joaquincasanova/ArdaraClone/docs/hs27.pdf

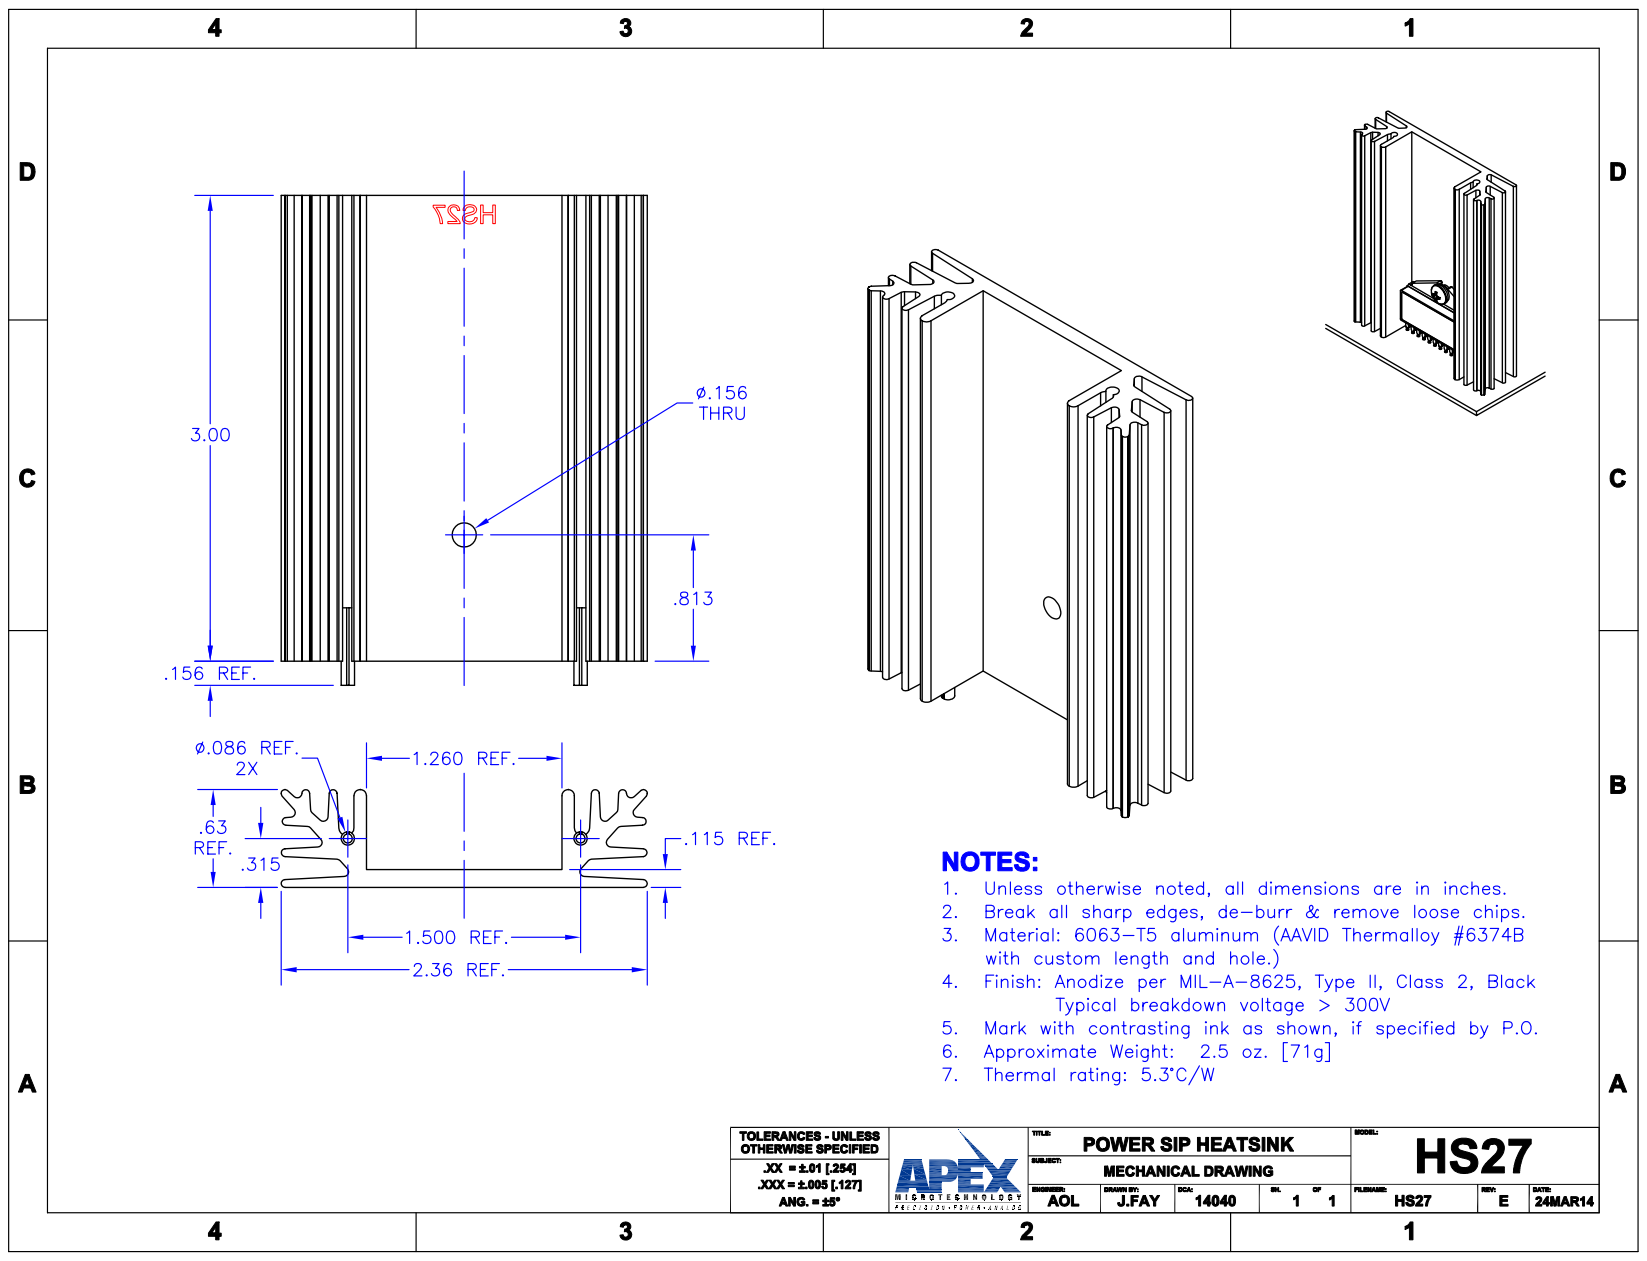
[picture p5: page 1]
