joaquincasanova/ArdaraClone/docs/dr.pdf

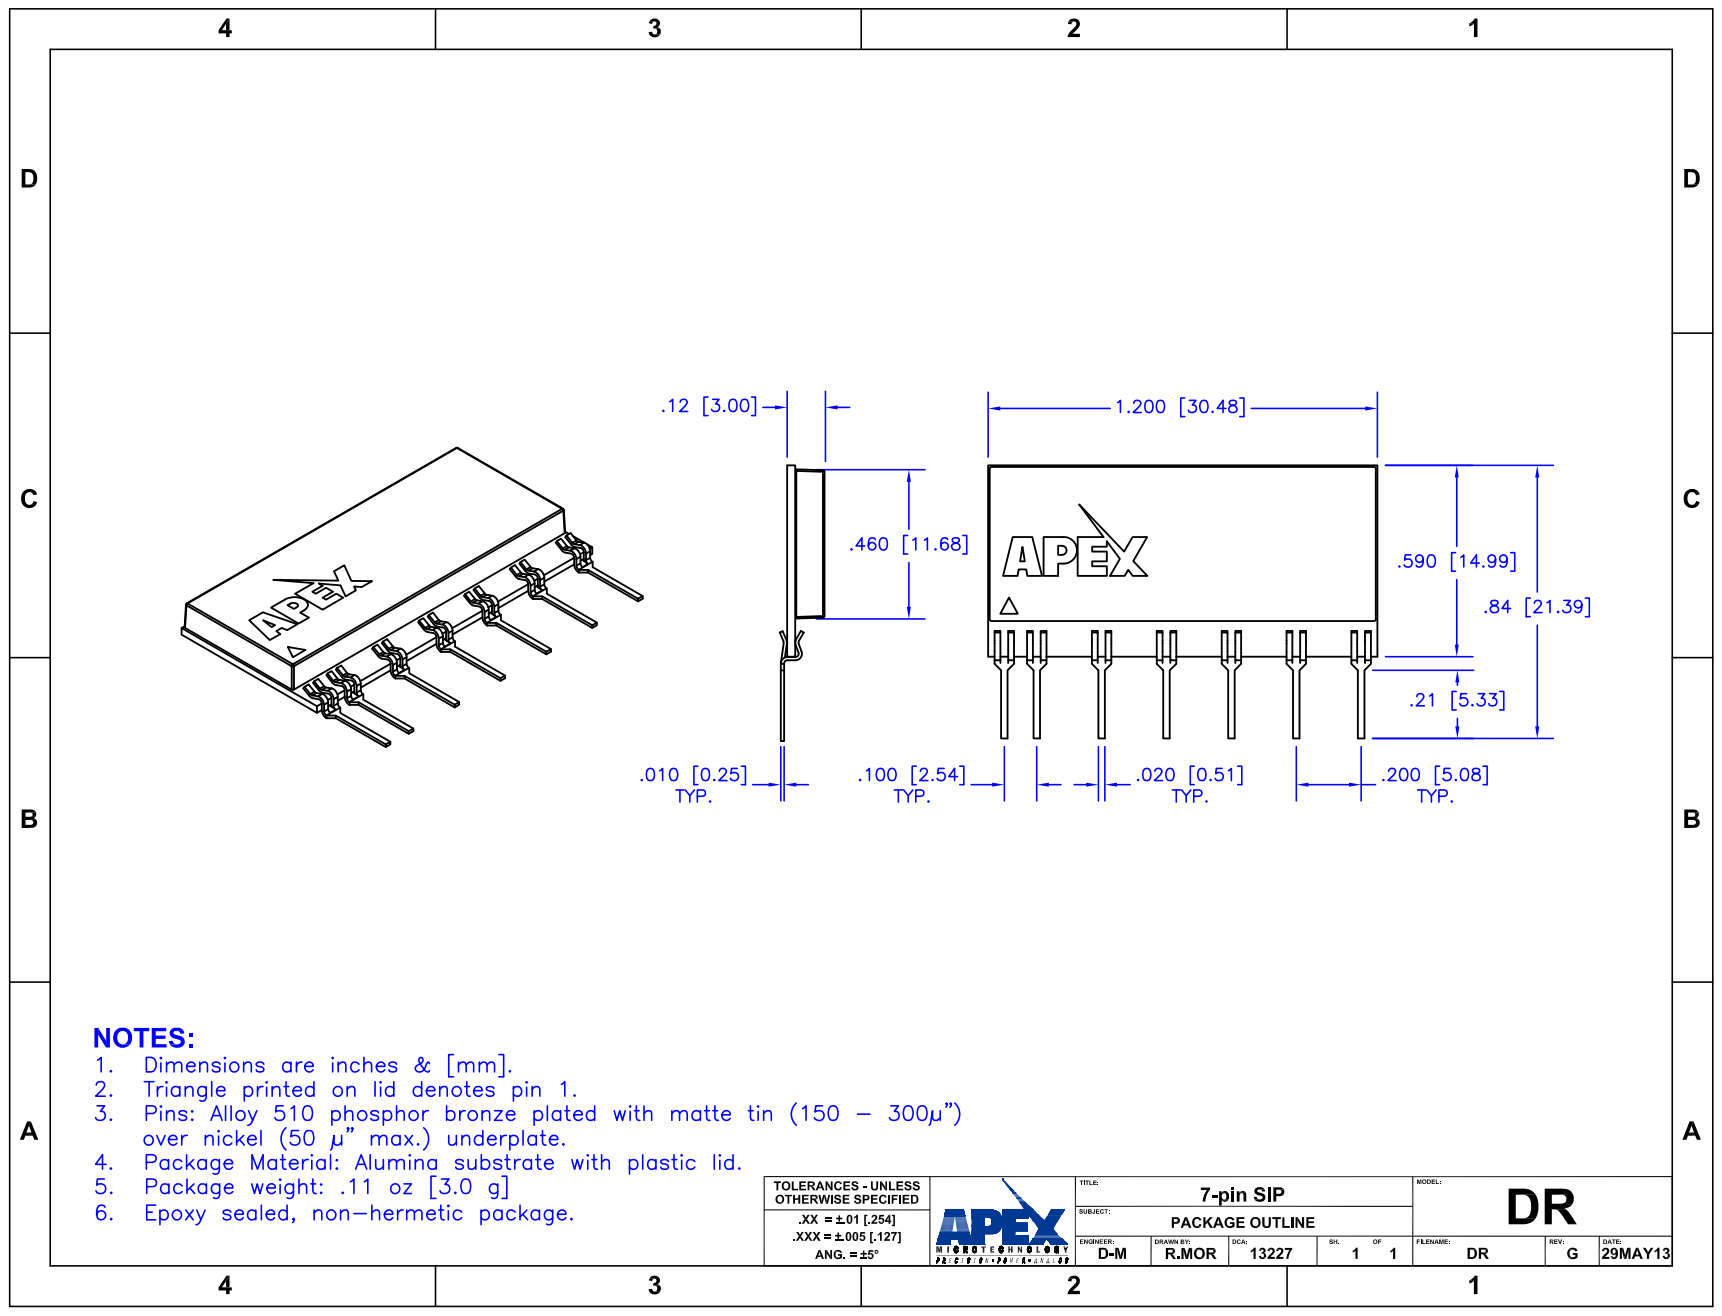
[picture p6: page 1]
