joaquincasanova/ArdaraClone/spice/summer.asc

R1: res; 240k
R2: res; 50k
R3: res; 50k
R12: res; 240k
U2: LT1355
V3: voltage; SINE(2.5 2.5 35000 0 0 0 0); AC 10 0
V4: voltage; 12
V5: voltage; -12
Named nets: 0, VIN, V+, V-, vout
;dc V3 -10 10 .1
.tran 100m
;.op
