joaquincasanova/ArdaraClone/spice/Draft11.asc

C1: cap; 10n
D1: diode; 1N4148
M1: nmos; STP8NM60
M2: nmos; STP8NM60
Q1: npn; 2N3904
R1: res; 1meg
R2: res; 250
R3: res; 65
R4: res; 10k
R5: res; 2meg
R6: res; 50k
R7: res; 100k
R8: res; 2.5k
R9: res; 100
R10: res; 10k
R11: res; 1meg
R12: res; 10k
R13: res; 10k
U1: PC817C
U3: LT1352
V1: voltage; 420
V2: voltage; -420
V3: voltage; SINE(0 10 100 0 0 0 0); AC 10 0
V4: voltage; 15
V5: voltage; -15
V6: voltage; 15
Named nets: 0, HV+, HV-, VIN, V+, V-, vout
;dc V3 -10 10 .1
.tran 100m
;.op
