joaquincasanova/ArdaraClone/spice/opto.asc

Q2: npn; 2N3904
R1: res; 120k
R2: res; 120k
R7: res; 40k
U1: PC817C
V1: voltage; 420
V2: voltage; -420
V3: voltage; SINE(0 10 100 0 0 0 0); AC 10 0
V4: voltage; 15
V5: voltage; -15
Named nets: 0, HV+, HV-, VIN, V+, V-
;dc V3 -10 10 .1
.tran 100m
