joaquincasanova/ArdaraClone/spice/Draft11degeneration.asc

C1: cap; 10n
C2: cap; 10n
D1: zener; 1N5378B
D2: diode; 1N4148
D3: zener; 1N5378B
D4: zener; 1N5378B
D5: zener; 1N5378B
D6: zener; 1N5378B
D7: zener; 1N5378B
D8: zener; 1N5378B
D9: zener; 1N5378B
D10: zener; 1N5378B
D11: zener; 1N5378B
M1: nmos; SPA11N60C3
M2: nmos; SPA11N60C3
R1: res; 1meg
R2: res; 100
R3: res; 2.5k
R4: res; 10k
R5: res; 2meg
R6: res; 50k
R7: res; 2.5k
R8: res; 25k
R9: res; 2.5k
R10: res; 10k
R11: res; 100
R12: res; 10k
R13: res; 1meg
U2: PC817A
U3: LT1352
V1: voltage; 420
V2: voltage; -420
V3: voltage; SINE(0 10 100 0 0 0 0); AC 10 0
V4: voltage; 12
V5: voltage; -12
V7: voltage; 15
Named nets: 0, HV+, HV-, VIN, V+, V-, vout
;dc V3 -10 10 .1
.tran 100m
;.op
