joaquincasanova/ArdaraClone/spice/Draft10.asc

C1: cap; 10n
D1: zener; BZX84C15L
D2: diode; 1N4148
M1: nmos; STP8NM60
M2: nmos; STP8NM60
Q1: npn; 2N2222
R1: res; 400k
R2: res; 2k
R3: res; 10
R4: res; 20k
R5: res; 1meg
R6: res; 24.39k
R7: res; 10k
R8: res; 25k
U1: LT1355
V1: voltage; 420
V2: voltage; -420
V3: voltage; 10
V4: voltage; 15
V5: voltage; -15
Named nets: 0, HV+, HV-, VIN, V+, V-
.dc V3 -10 10 .1
