joaquincasanova/ArdaraClone/spice/Draft11b.asc

C1: cap; 10n
C2: cap; 10n
C3: cap; 1n
D1: zener; 1N5378B
D2: diode; 1N4148
D3: zener; 1N5378B
D4: zener; 1N5378B
D5: zener; 1N5378B
D6: zener; 1N5378B
D7: zener; 1N5378B
D8: zener; 1N5378B
D9: zener; 1N5378B
D10: zener; 1N5378B
D11: zener; 1N5378B
M1: nmos; STP8NM60
M2: nmos; STP8NM60
Q1: npn; 2N2222
Q2: npn; 2N2222
Q3: pnp; 2N3906
Q7: pnp; 2N3906
R1: res; 400k
R2: res; 10k
R3: res; 65
R4: res; 20k
R5: res; 1meg
R6: res; 24.39k
R7: res; 10k
R8: res; 15k
R9: res; 65
R11: res; 100k
R16: res; 300K
U1: LT1355
V1: voltage; 420
V2: voltage; -420
V3: voltage; SINE(0 10 10 0 0 0 0); AC 10 0
V4: voltage; 15
V5: voltage; -15
V6: voltage; 7.5
Named nets: 0, HV+, HV-, VIN, V+, V-, vout, V+/2
;dc V3 -10 10 .1
.tran 100m
;.op
