joaquincasanova/ArdaraClone/spice/Draft12.asc

C1: cap; 10n
M1: pmos; IRFP9240
M2: nmos; STP8NM60
Q1: npn; 2N2222
Q2: pnp
R1: res; 10k
R2: res; 10
R3: res; 10
R4: res; 20k
R5: res; 1meg
R6: res; 24.39k
R7: res; 10k
R9: res; 10k
R10: res; 8k
R11: res; 10k
U1: LT1355
U3: PC817A
U5: PC817A
V1: voltage; 420
V2: voltage; -420
V3: voltage; PULSE(-10 10 10m 10u 10u 10m 20m); AC 10 0
V4: voltage; 15
V5: voltage; -15
V6: voltage; 12
V8: voltage; 12
Named nets: 0, HV+, HV-, VIN, V+, V-
;ac dec 10 1 100000
;dc V3 -10 10 .1
.tran 100m
