joaquincasanova/ArdaraClone/spice/Draft13.asc

C1: cap; 40p
C2: cap; 10n
C3: cap; 1n
D1: zener; 1N5378B
D2: diode; 1N4148
D3: zener; 1N5378B
D4: zener; 1N5378B
D5: zener; 1N5378B
D6: zener; 1N5378B
D7: zener; 1N5378B
D8: zener; 1N5378B
D9: zener; 1N5378B
D10: zener; 1N5378B
D11: zener; 1N5378B
D12: diode; 1N4148
Q1: npn; 2N3904
Q2: npn; 2N3904
Q4: pnp; 2N3906
R1: res; 100K
R2: res; 10k
R3: res; 4meg
R4: res; 3k
R5: res; 1meg
R6: res; 24.39k
R7: res; 10k
R8: res; 10k
R9: res; 10k
R11: res; 100k
U1: LT1355
V1: voltage; 420
V2: voltage; -420
V3: voltage; SINE(0 10 100 0 0 0 0); AC 10 0
V4: voltage; 15
V5: voltage; -15
Named nets: 0, HV+, HV-, VIN, V+, V-, vout
;dc V3 -10 10 .1
.tran 100m
;.op
