joaquincasanova/ArdaraClone/eagle/regulator_plus_switch_multi_no_rdbk.brd

## EAGLE design eagle/regulator_plus_switch_multi_no_rdbk.brd (2016-05-18)

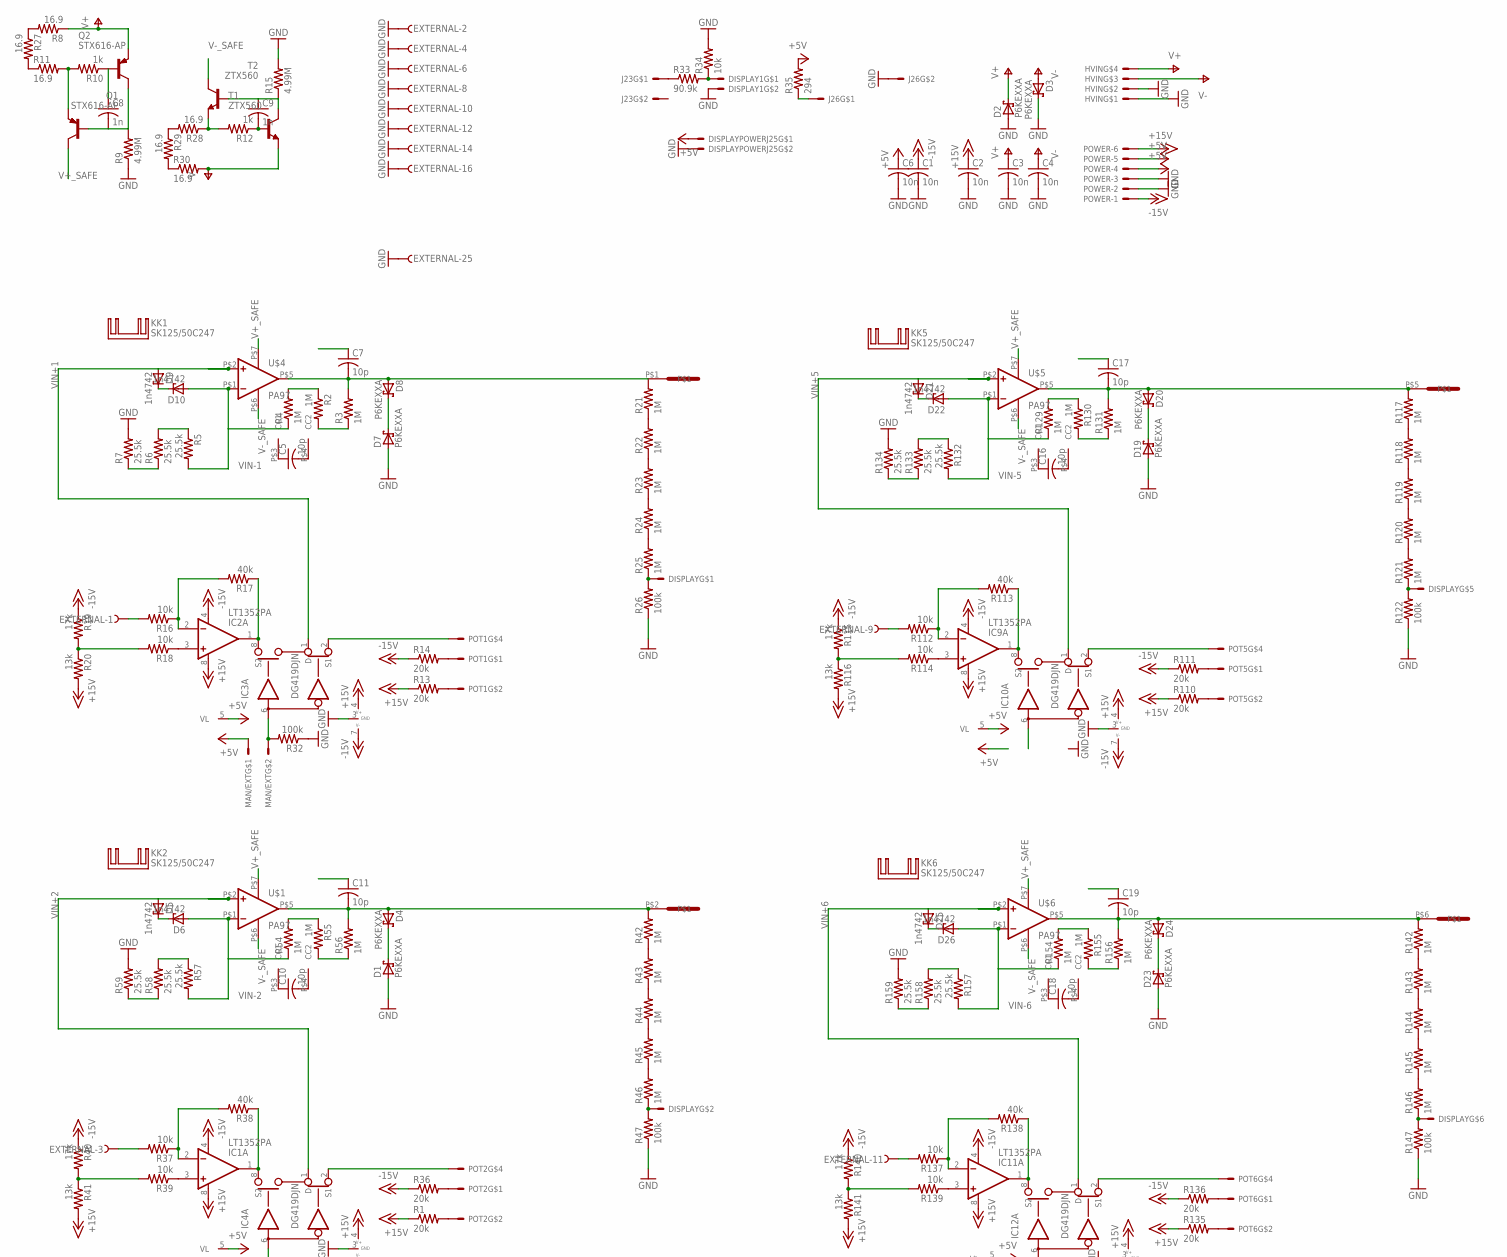
[picture p7: schematic regulator_plus_switch_multi_no_rdbk.sch, part in row 1, column 1]

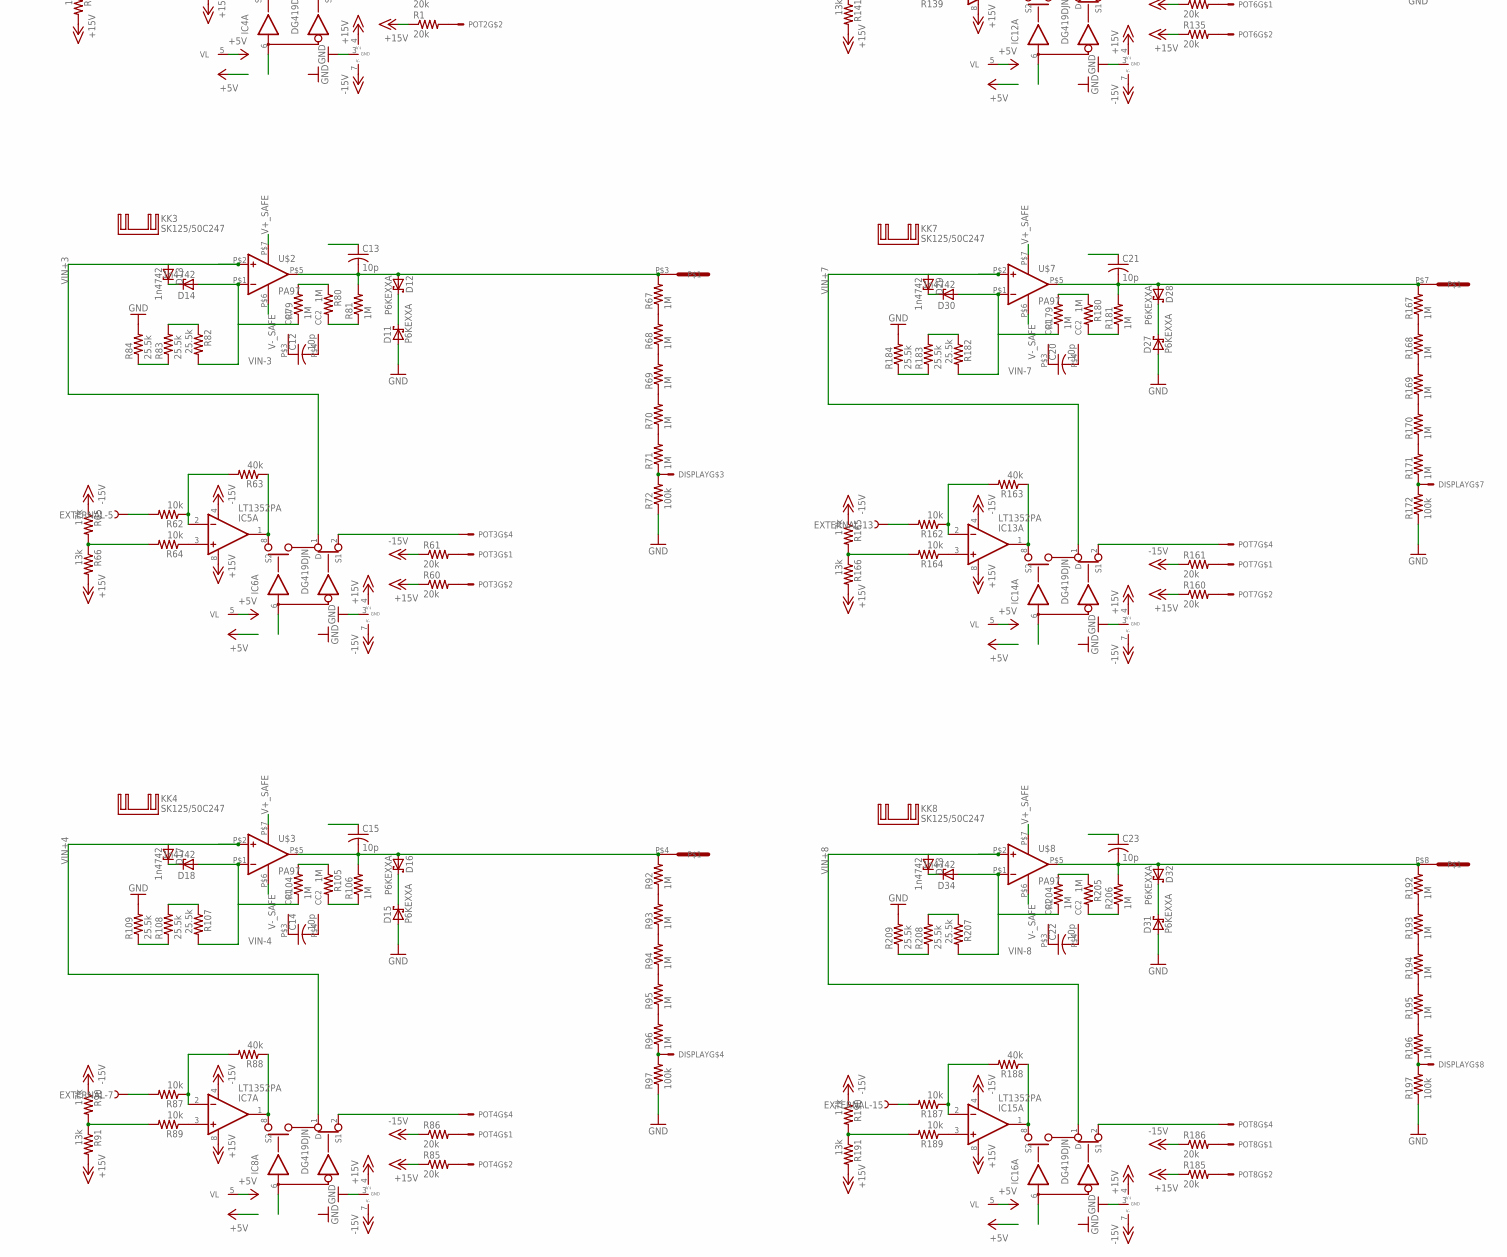
[picture p8: schematic regulator_plus_switch_multi_no_rdbk.sch, part in row 2, column 1]

Parts:
C1, C2, C3, C4, C6: 10n; C075-032X103
C5, C7, C10, C11, C12, C13, C14, C15, C16, C17, C18, C19, C20, C21, C22, C23: 10p; C075-032X103
C8, C9: 1n; C075-032X103
D1, D2, D3, D4, D7, D8, D11, D12, D15, D16, D19, D20, D23, D24, D27, D28, D31, D32: P6KEXXA; C1702-15
D5, D6, D9, D10, D13, D14, D17, D18, D21, D22, D25, D26, D29, D30, D33, D34: 1n4742; DO41Z10
DISPLAY: 5669-8
DISPLAY1: 5569-2
DISPLAYPOWERJ25: 5569-2
EXTERNAL: F25HPS; F25HP
HVIN: 5569-4; 5669-4
IC1, IC2, IC5, IC7, IC9, IC11, IC13, IC15: LT1352PA; DIL08
IC3, IC4, IC6, IC8, IC10, IC12, IC14, IC16: DG419DJN; DIL08
J23, J26: 5569-2
KK1, KK2, KK3, KK4, KK5, KK6, KK7, KK8: SK125/50C247; C247-050
MAN/EXT: 5569-2
OUT: 640584-1
POT1, POT2, POT3, POT4, POT5, POT6, POT7, POT8: 5569-4; 5669-4
POWER: KK-156-6
Q1, Q2: STX616-AP; TO92L
R1, R13, R14, R36, R60, R61, R85, R86, R110, R111, R135, R136, R160, R161, R185, R186: 20k; 0207/10
R2, R3, R4, R21, R22, R23, R24, R25, R42, R43, R44, R45, R46, R54, R55, R56, R67, R68, R69, R70, R71, R79, R80, R81, R92, R93, R94, R95, R96, R104, R105, R106, R117, R118, R119, R120, R121, R129, R130, R131, R142, R143, R144, R145, R146, R154, R155, R156, R167, R168, R169, R170, R171, R179, R180, R181, R192, R193, R194, R195, R196, R204, R205, R206: 1M; 0207/10
R5, R6, R7, R57, R58, R59, R82, R83, R84, R107, R108, R109, R132, R133, R134, R157, R158, R159, R182, R183, R184, R207, R208, R209: 25.5k; 0207/10
R8, R11, R27, R28, R29, R30: 16.9; 0207/10
R9, R15: 4.99M; 0207/10
R10, R12: 1k; 0207/10
R16, R18, R34, R37, R39, R62, R64, R87, R89, R112, R114, R137, R139, R162, R164, R187, R189: 10k; 0207/10
R17, R38, R63, R88, R113, R138, R163, R188: 40k; 0207/10
R19, R40, R65, R90, R115, R140, R165, R190: 17k; 0207/10
R20, R41, R66, R91, R116, R141, R166, R191: 13k; 0207/10
R26, R32, R47, R72, R97, R122, R147, R172, R197: 100k; 0207/10
R33: 90.9k; 0207/10
R35: 294; 0207/10
T1, T2: ZTX560; TO92L
U$1, U$2, U$3, U$4, U$5, U$6, U$7, U$8: PA97; 7SIP

Connections:
+5V: C6.1, DISPLAYPOWERJ25.P$1, IC3.5 (VL), IC4.5 (VL), IC6.5 (VL), IC8.5 (VL), IC10.5 (VL), IC12.5 (VL), IC14.5 (VL), IC16.5 (VL), MAN/EXT.P$1, POWER.4, POWER.5, R35.2
+15V: C2.1, IC1.8 (V+), IC2.8 (V+), IC3.4 (V+), IC4.4 (V+), IC5.8 (V+), IC6.4 (V+), IC7.8 (V+), IC8.4 (V+), IC9.8 (V+), IC10.4 (V+), IC11.8 (V+), IC12.4 (V+), IC13.8 (V+), IC14.4 (V+), IC15.8 (V+), IC16.4 (V+), POWER.6, R1.1, R13.1, R20.2, R41.2, R60.1, R66.2, R85.1, R91.2, R110.1, R116.2, R135.1, R141.2, R160.1, R166.2, R185.1, R191.2
-15V: C1.1, IC1.4 (V-), IC2.4 (V-), IC3.7 (V-), IC4.7 (V-), IC5.4 (V-), IC6.7 (V-), IC7.4 (V-), IC8.7 (V-), IC9.4 (V-), IC10.7 (V-), IC11.4 (V-), IC12.7 (V-), IC13.4 (V-), IC14.7 (V-), IC15.4 (V-), IC16.7 (V-), POWER.1, R14.1, R19.1, R36.1, R40.1, R61.1, R65.1, R86.1, R90.1, R111.1, R115.1, R136.1, R140.1, R161.1, R165.1, R186.1, R190.1
GND: C1.2, C2.2, C3.2, C4.2, C6.2, D1.A, D2.A, D3.C, D7.A, D11.A, D15.A, D19.A, D23.A, D27.A, D31.A, DISPLAY1.P$2, DISPLAYPOWERJ25.P$2, EXTERNAL.2, EXTERNAL.4, EXTERNAL.6, EXTERNAL.8, EXTERNAL.10, EXTERNAL.12, EXTERNAL.14, EXTERNAL.16, EXTERNAL.25, HVIN.P$1, HVIN.P$2, IC3.3 (GND), IC4.3 (GND), IC6.3 (GND), IC8.3 (GND), IC10.3 (GND), IC12.3 (GND), IC14.3 (GND), IC16.3 (GND), J26.P$2, POWER.2, POWER.3, R7.2, R9.1, R15.2, R26.1, R32.1, R34.2, R47.1, R59.2, R72.1, R84.2, R97.1, R109.2, R122.1, R134.2, R147.1, R159.2, R172.1, R184.2, R197.1, R209.2
MAN: IC3.6 (IN), IC4.6 (IN), IC6.6 (IN), IC8.6 (IN), IC10.6 (IN), IC12.6 (IN), IC14.6 (IN), IC16.6 (IN), MAN/EXT.P$2, R32.2
unnamed: R12.2, R28.1, T2.1 (E)
unnamed: C8.1, Q2.2 (B), R10.1
unnamed: C5.1, U$4.P$3 (CC1)
unnamed: C5.2, U$4.P$4 (CC2)
unnamed: Q1.3 (E), R10.2, R11.2
unnamed: IC1.2 (-IN), R37.1, R38.2
unnamed: IC1.3 (+IN), R39.1
unnamed: D7.C, D8.C
unnamed: POT1.P$2, R13.2
unnamed: C8.2, Q1.2 (B), Q2.1 (C), R9.2
unnamed: C7.2, D8.A, OUT.P$1, R3.2, R21.2, U$4.P$5 (OUT)
unnamed: R2.1, R4.2
unnamed: IC3.2 (S1), POT1.P$4
unnamed: R5.1, R6.2
unnamed: POT1.P$1, R14.2
unnamed: R6.1, R7.1
unnamed: C9.2, R12.1, T1.2 (B)
unnamed: R2.2, R3.1
unnamed: C9.1, R15.1, T1.3 (C), T2.2 (B)
unnamed: DISPLAY1.P$1, R33.2, R34.1
unnamed: J23.P$1, R33.1
unnamed: J26.P$1, R35.1
unnamed: R39.2, R40.2, R41.1
unnamed: IC2.2 (-IN), R16.1, R17.2
unnamed: IC2.3 (+IN), R18.1
unnamed: R18.2, R19.2, R20.1
unnamed: IC2.1 (OUT), IC3.8 (S2), R17.1
unnamed: IC1.1 (OUT), IC4.8 (S2), R38.1
unnamed: D9.C, D10.C
unnamed: R21.1, R22.2
unnamed: R22.1, R23.2
unnamed: R23.1, R24.2
unnamed: R24.1, R25.2
unnamed: R8.2, R27.1
unnamed: R11.1, R27.2
unnamed: DISPLAY.P$2, R46.1, R47.2
unnamed: DISPLAY.P$3, R71.1, R72.2
unnamed: R42.1, R43.2
unnamed: DISPLAY.P$4, R96.1, R97.2
unnamed: R43.1, R44.2
unnamed: R44.1, R45.2
unnamed: R45.1, R46.2
unnamed: DISPLAY.P$5, R121.1, R122.2
unnamed: DISPLAY.P$6, R146.1, R147.2
unnamed: DISPLAY.P$7, R171.1, R172.2
unnamed: DISPLAY.P$8, R196.1, R197.2
unnamed: R28.2, R29.1
unnamed: POT2.P$2, R1.2
unnamed: IC4.2 (S1), POT2.P$4
unnamed: POT2.P$1, R36.2
unnamed: C10.1, U$1.P$3 (CC1)
unnamed: C10.2, U$1.P$4 (CC2)
unnamed: C11.2, D4.A, OUT.P$2, R42.2, R56.2, U$1.P$5 (OUT)
unnamed: D1.C, D4.C
unnamed: R54.2, R55.1
unnamed: R57.1, R58.2
unnamed: R58.1, R59.1
unnamed: R55.2, R56.1
unnamed: D5.C, D6.C
unnamed: IC5.2 (-IN), R62.1, R63.2
unnamed: IC5.3 (+IN), R64.1
unnamed: R64.2, R65.2, R66.1
unnamed: IC5.1 (OUT), IC6.8 (S2), R63.1
unnamed: R67.1, R68.2
unnamed: R68.1, R69.2
unnamed: R69.1, R70.2
unnamed: R70.1, R71.2
unnamed: R29.2, R30.1
unnamed: EXTERNAL.1, R16.2
unnamed: EXTERNAL.3, R37.2
unnamed: EXTERNAL.5, R62.2
unnamed: EXTERNAL.7, R87.2
unnamed: POT3.P$2, R60.2
unnamed: IC6.2 (S1), POT3.P$4
unnamed: POT3.P$1, R61.2
unnamed: C12.1, U$2.P$3 (CC1)
unnamed: C12.2, U$2.P$4 (CC2)
unnamed: C13.2, D12.A, OUT.P$3, R67.2, R81.2, U$2.P$5 (OUT)
unnamed: D11.C, D12.C
unnamed: R79.2, R80.1
unnamed: R82.1, R83.2
unnamed: R83.1, R84.1
unnamed: R80.2, R81.1
unnamed: D13.C, D14.C
unnamed: IC7.2 (-IN), R87.1, R88.2
unnamed: IC7.3 (+IN), R89.1
unnamed: R89.2, R90.2, R91.1
unnamed: IC7.1 (OUT), IC8.8 (S2), R88.1
unnamed: R92.1, R93.2
unnamed: R93.1, R94.2
unnamed: R94.1, R95.2
unnamed: R95.1, R96.2
unnamed: EXTERNAL.9, R112.2
unnamed: EXTERNAL.11, R137.2
unnamed: EXTERNAL.13, R162.2
unnamed: EXTERNAL.15, R187.2
unnamed: POT4.P$2, R85.2
unnamed: IC8.2 (S1), POT4.P$4
unnamed: POT4.P$1, R86.2
unnamed: C14.1, U$3.P$3 (CC1)
unnamed: C14.2, U$3.P$4 (CC2)
unnamed: C15.2, D16.A, OUT.P$4, R92.2, R106.2, U$3.P$5 (OUT)
unnamed: D15.C, D16.C
unnamed: R104.2, R105.1
unnamed: R107.1, R108.2
unnamed: R108.1, R109.1
unnamed: R105.2, R106.1
unnamed: D17.C, D18.C
unnamed: IC9.2 (-IN), R112.1, R113.2
unnamed: IC9.3 (+IN), R114.1
unnamed: R114.2, R115.2, R116.1
unnamed: IC9.1 (OUT), IC10.8 (S2), R113.1
unnamed: R117.1, R118.2
unnamed: R118.1, R119.2
unnamed: R119.1, R120.2
unnamed: R120.1, R121.2
unnamed: POT5.P$2, R110.2
unnamed: IC10.2 (S1), POT5.P$4
unnamed: POT5.P$1, R111.2
unnamed: C16.1, U$5.P$3 (CC1)
unnamed: C16.2, U$5.P$4 (CC2)
unnamed: C17.2, D20.A, OUT.P$5, R117.2, R131.2, U$5.P$5 (OUT)
unnamed: D19.C, D20.C
unnamed: R129.2, R130.1
unnamed: R132.1, R133.2
unnamed: R133.1, R134.1
unnamed: R130.2, R131.1
unnamed: D21.C, D22.C
unnamed: IC11.2 (-IN), R137.1, R138.2
unnamed: IC11.3 (+IN), R139.1
unnamed: R139.2, R140.2, R141.1
unnamed: IC11.1 (OUT), IC12.8 (S2), R138.1
unnamed: R142.1, R143.2
unnamed: R143.1, R144.2
unnamed: R144.1, R145.2
unnamed: R145.1, R146.2
unnamed: POT6.P$2, R135.2
unnamed: IC12.2 (S1), POT6.P$4
unnamed: POT6.P$1, R136.2
unnamed: C18.1, U$6.P$3 (CC1)
unnamed: C18.2, U$6.P$4 (CC2)
unnamed: C19.2, D24.A, OUT.P$6, R142.2, R156.2, U$6.P$5 (OUT)
unnamed: D23.C, D24.C
unnamed: R154.2, R155.1
unnamed: R157.1, R158.2
unnamed: R158.1, R159.1
unnamed: R155.2, R156.1
unnamed: D25.C, D26.C
unnamed: IC13.2 (-IN), R162.1, R163.2
unnamed: IC13.3 (+IN), R164.1
unnamed: R164.2, R165.2, R166.1
unnamed: IC13.1 (OUT), IC14.8 (S2), R163.1
unnamed: R167.1, R168.2
unnamed: R168.1, R169.2
unnamed: R169.1, R170.2
unnamed: R170.1, R171.2
unnamed: POT7.P$2, R160.2
unnamed: IC14.2 (S1), POT7.P$4
unnamed: POT7.P$1, R161.2
unnamed: C20.1, U$7.P$3 (CC1)
unnamed: C20.2, U$7.P$4 (CC2)
unnamed: C21.2, D28.A, OUT.P$7, R167.2, R181.2, U$7.P$5 (OUT)
unnamed: D27.C, D28.C
unnamed: R179.2, R180.1
unnamed: R182.1, R183.2
unnamed: R183.1, R184.1
unnamed: R180.2, R181.1
unnamed: D29.C, D30.C
unnamed: IC15.2 (-IN), R187.1, R188.2
unnamed: IC15.3 (+IN), R189.1
unnamed: R189.2, R190.2, R191.1
unnamed: IC15.1 (OUT), IC16.8 (S2), R188.1
unnamed: R192.1, R193.2
unnamed: R193.1, R194.2
unnamed: R194.1, R195.2
unnamed: R195.1, R196.2
unnamed: POT8.P$2, R185.2
unnamed: IC16.2 (S1), POT8.P$4
unnamed: POT8.P$1, R186.2
unnamed: C22.1, U$8.P$3 (CC1)
unnamed: C22.2, U$8.P$4 (CC2)
unnamed: C23.2, D32.A, OUT.P$8, R192.2, R206.2, U$8.P$5 (OUT)
unnamed: D31.C, D32.C
unnamed: R204.2, R205.1
unnamed: R207.1, R208.2
unnamed: R208.1, R209.1
unnamed: R205.2, R206.1
unnamed: D33.C, D34.C
unnamed: DISPLAY.P$1, R25.1, R26.2
V+: C3.1, D2.C, HVIN.P$4, Q2.3 (E), R8.1
V+_SAFE: Q1.1 (C), U$1.P$7 (V+), U$2.P$7 (V+), U$3.P$7 (V+), U$4.P$7 (V+), U$5.P$7 (V+), U$6.P$7 (V+), U$7.P$7 (V+), U$8.P$7 (V+)
V-: C4.1, D3.A, HVIN.P$3, R30.2, T1.1 (E)
V-_SAFE: T2.3 (C), U$1.P$6 (V-), U$2.P$6 (V-), U$3.P$6 (V-), U$4.P$6 (V-), U$5.P$6 (V-), U$6.P$6 (V-), U$7.P$6 (V-), U$8.P$6 (V-)
VIN+1: D9.A, IC3.1 (D), U$4.P$2 (+IN)
VIN+2: D5.A, IC4.1 (D), U$1.P$2 (+IN)
VIN+3: D13.A, IC6.1 (D), U$2.P$2 (+IN)
VIN+4: D17.A, IC8.1 (D), U$3.P$2 (+IN)
VIN+5: D21.A, IC10.1 (D), U$5.P$2 (+IN)
VIN+6: D25.A, IC12.1 (D), U$6.P$2 (+IN)
VIN+7: D29.A, IC14.1 (D), U$7.P$2 (+IN)
VIN+8: D33.A, IC16.1 (D), U$8.P$2 (+IN)
VIN-1: C7.1, D10.A, R4.1, R5.2, U$4.P$1 (-IN)
VIN-2: C11.1, D6.A, R54.1, R57.2, U$1.P$1 (-IN)
VIN-3: C13.1, D14.A, R79.1, R82.2, U$2.P$1 (-IN)
VIN-4: C15.1, D18.A, R104.1, R107.2, U$3.P$1 (-IN)
VIN-5: C17.1, D22.A, R129.1, R132.2, U$5.P$1 (-IN)
VIN-6: C19.1, D26.A, R154.1, R157.2, U$6.P$1 (-IN)
VIN-7: C21.1, D30.A, R179.1, R182.2, U$7.P$1 (-IN)
VIN-8: C23.1, D34.A, R204.1, R207.2, U$8.P$1 (-IN)

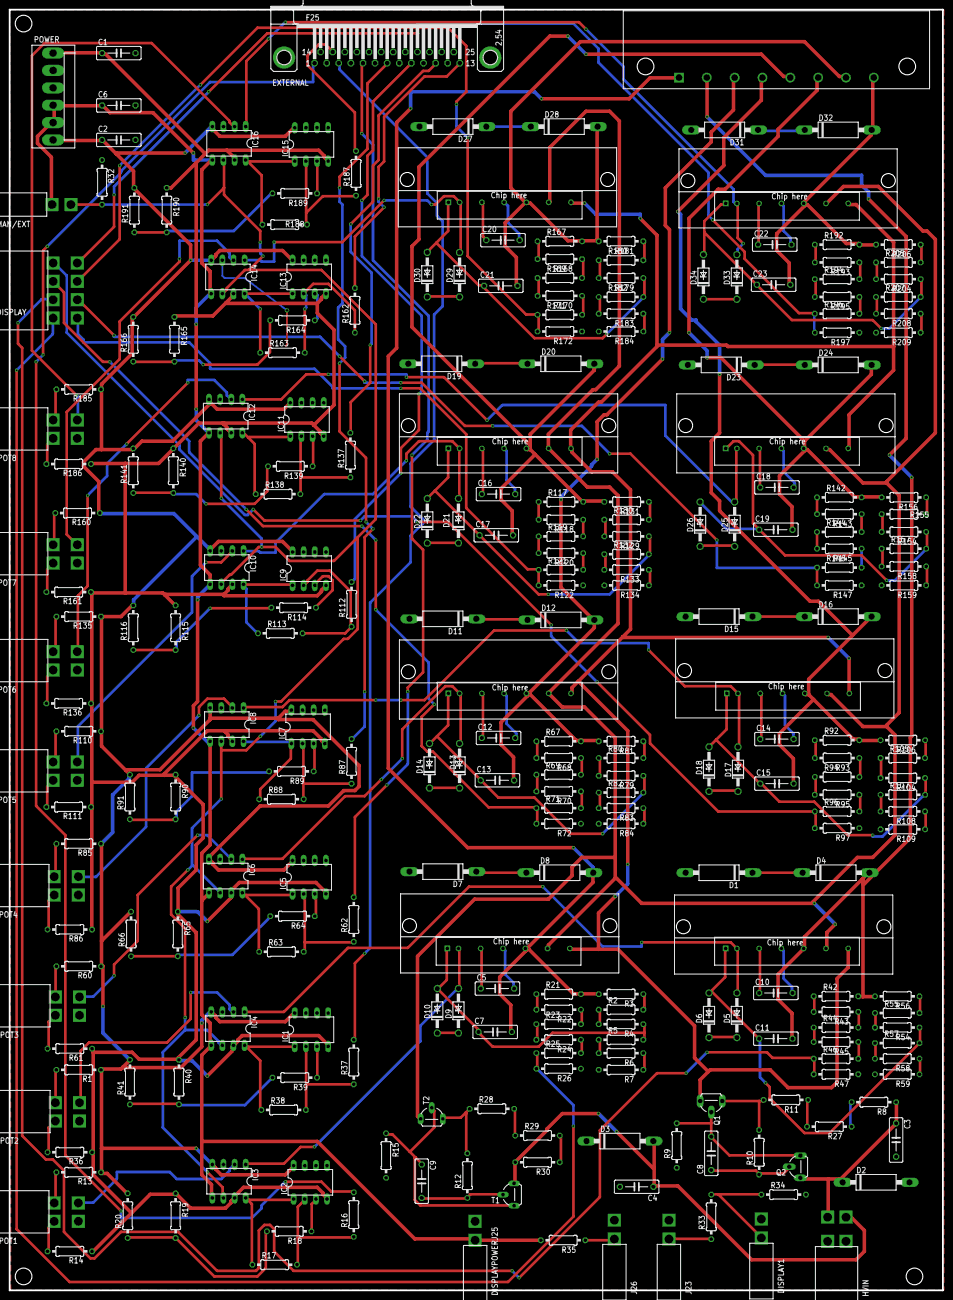
[picture p9: board regulator_plus_switch_multi_no_rdbk.brd from above]

Board: 2 copper layers, 212.9 x 292.1 mm, 277 parts (0 on the bottom side), 214 nets.
