joaquincasanova/ArdaraClone/eagle/pa97.brd

## EAGLE design eagle/pa97.brd (2016-03-18)

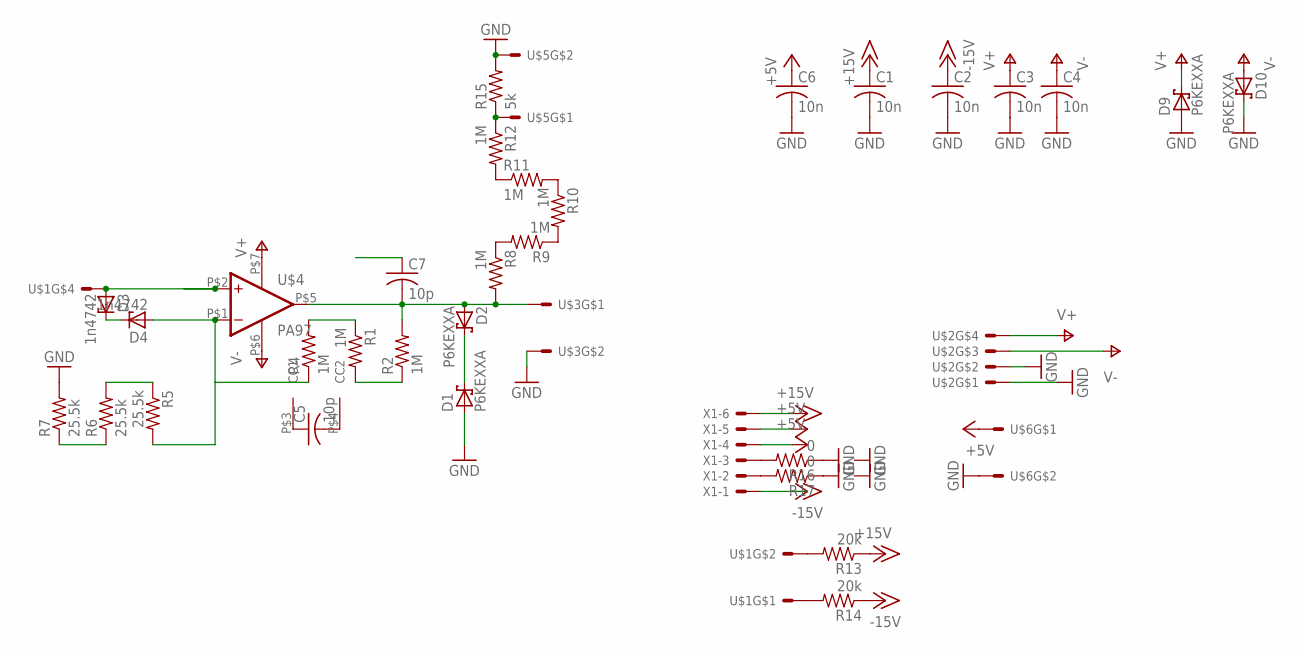
[picture p10: schematic pa97.sch]

Parts:
C1, C2, C3, C4, C6: 10n; C075-032X103
C5, C7: 10p; C075-032X103
D1, D2, D9, D10: P6KEXXA; C1702-15
D3, D4: 1n4742; DO41Z10
R1, R2, R4, R8, R9, R10, R11, R12: 1M; 0207/10
R5, R6, R7: 25.5k; 0207/10
R13, R14: 20k; 0207/10
R15: 5k; 0207/10
R16, R17: 0; 0207/10
U$1, U$2: 5569-4; 5669-4
U$3, U$5, U$6: 5569-2
U$4: PA97; 7SIP
X1: KK-156-6

Connections:
+5V: C6.1, U$6.P$1, X1.4, X1.5
+15V: C1.1, R13.1, X1.6
-15V: C2.1, R14.1, X1.1
GND: C1.2, C2.2, C3.2, C4.2, C6.2, D1.A, D9.A, D10.C, R7.2, R15.2, R16.1, R17.1, U$2.P$1, U$2.P$2, U$3.P$2, U$5.P$2, U$6.P$2
unnamed: D1.C, D2.C
unnamed: R1.1, R4.2
unnamed: D4.A, R4.1, R5.2, U$4.P$1 (-IN)
unnamed: R5.1, R6.2
unnamed: R6.1, R7.1
unnamed: C5.1, U$4.P$3 (CC1)
unnamed: C5.2, U$4.P$4 (CC2)
unnamed: R1.2, R2.1
unnamed: R13.2, U$1.P$2
unnamed: C7.2, D2.A, R2.2, R8.2, U$3.P$1, U$4.P$5 (OUT)
unnamed: R8.1, R9.2
unnamed: D3.A, U$1.P$4, U$4.P$2 (+IN)
unnamed: R9.1, R10.2
unnamed: R10.1, R11.2
unnamed: R11.1, R12.2
unnamed: R12.1, R15.1, U$5.P$1
unnamed: R16.2, X1.3
unnamed: R17.2, X1.2
unnamed: D3.C, D4.C
unnamed: R14.2, U$1.P$1
V+: C3.1, D9.C, U$2.P$4, U$4.P$7 (V+)
V-: C4.1, D10.A, U$2.P$3, U$4.P$6 (V-)

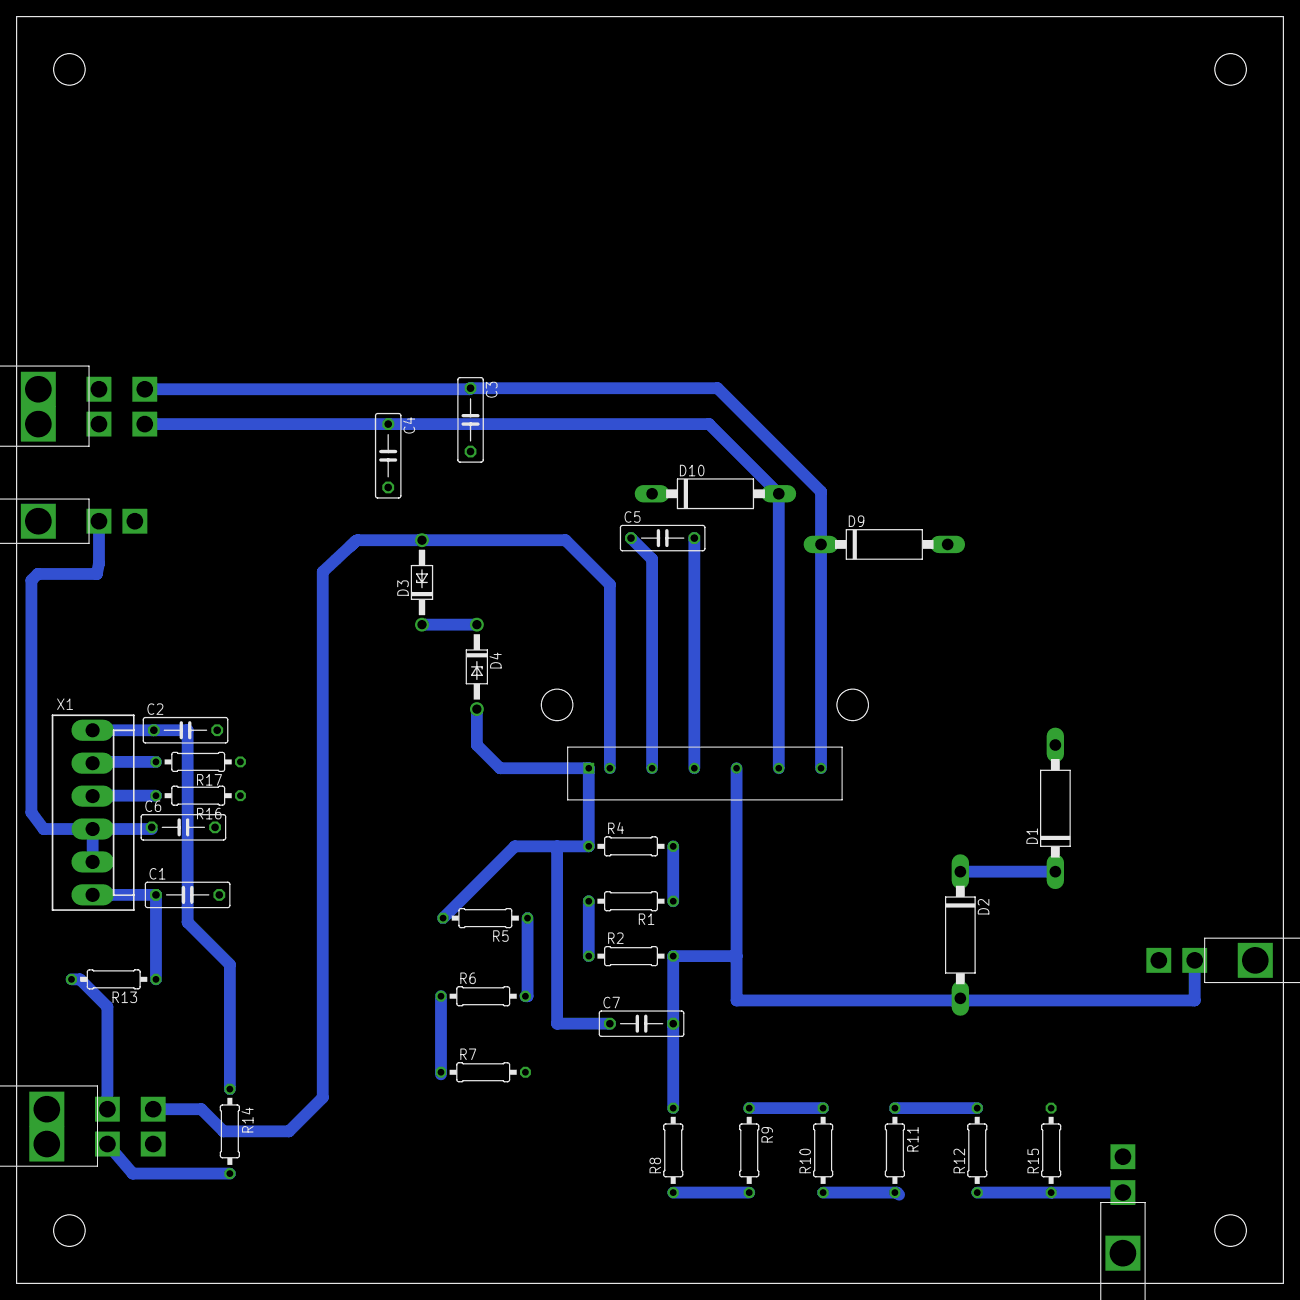
[picture p11: board pa97.brd from above]

Board: 2 copper layers, 152.4 x 152.4 mm, 36 parts (0 on the bottom side), 26 nets.
