joaquincasanova/ArdaraClone/eagle/test_ckt_2.brd

## EAGLE design eagle/test_ckt_2.brd (2016-02-24)

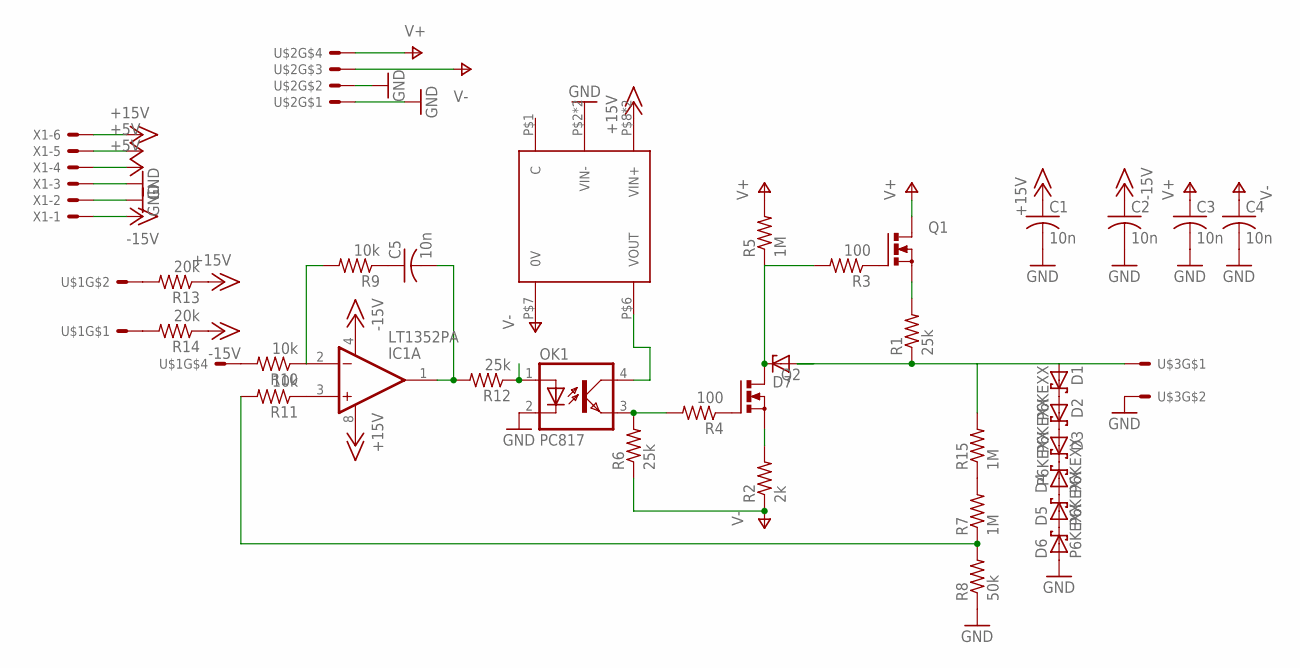
[picture p12: schematic test_ckt_2.sch]

Parts:
C1, C2, C3, C4, C5: 10n; C075-032X103
D1, D2, D3, D4, D5, D6: P6KEXX; CB417-15
D7: ZENER-DIODEZD-12.5; ZDIO12.5
DC1: NCS
IC1: LT1352PA; DIL08
OK1: PC817; DIL04
Q1, Q2: PMOSFET_NTO220BV; TO220BV
R1, R6: 25k; 0207/10
R2: 2k; 0207/10
R3, R4: 100; 0207/10
R5, R7, R15: 1M; 0414/15
R8: 50k; 0207/10
R9, R10, R11: 10k; 0207/10
R12: 25k; 0207/15
R13, R14: 20k; 0207/10
U$1, U$2: 5569-4; 5669-4
U$3: 5569-2
X1: KK-156-6

Connections:
+5V: X1.4, X1.5
+15V: C1.1, DC1.P$8 (VIN+), DC1.P$9 (VIN+), IC1.8 (V+), R13.1, X1.6
-15V: C2.1, IC1.4 (V-), R14.1, X1.1
GND: C1.2, C2.2, C3.2, C4.2, D6.A, DC1.P$2 (VIN-), DC1.P$3 (VIN-), OK1.2 (C), R8.1, U$2.P$1, U$2.P$2, U$3.P$2, X1.2, X1.3
unnamed: D1.C, D2.A
unnamed: D2.C, D3.A
unnamed: D3.C, D4.C
unnamed: D4.A, D5.C
unnamed: D5.A, D6.C
unnamed: Q1.G, R3.1
unnamed: D7.C, Q2.D, R3.2, R5.1
unnamed: Q1.S, R1.2
unnamed: R13.2, U$1.P$2
unnamed: D1.A, D7.A, R1.1, R15.2, U$3.P$1
unnamed: Q2.G, R4.1
unnamed: OK1.3 (EMIT), R4.2, R6.2
unnamed: R10.2, U$1.P$4
unnamed: Q2.S, R2.2
unnamed: DC1.P$6 (VOUT), OK1.4 (COL)
unnamed: C5.1, R9.1
unnamed: IC1.2 (-IN), R9.2, R10.1
unnamed: C5.2, IC1.1 (OUT), R12.2
unnamed: IC1.3 (+IN), R11.1
unnamed: R7.1, R8.2, R11.2
unnamed: R7.2, R15.1
unnamed: R14.2, U$1.P$1
unnamed: OK1.1 (A), R12.1
V+: C3.1, Q1.D, R5.2, U$2.P$4
V-: C4.1, DC1.P$7 (0V), R2.1, R6.1, U$2.P$3

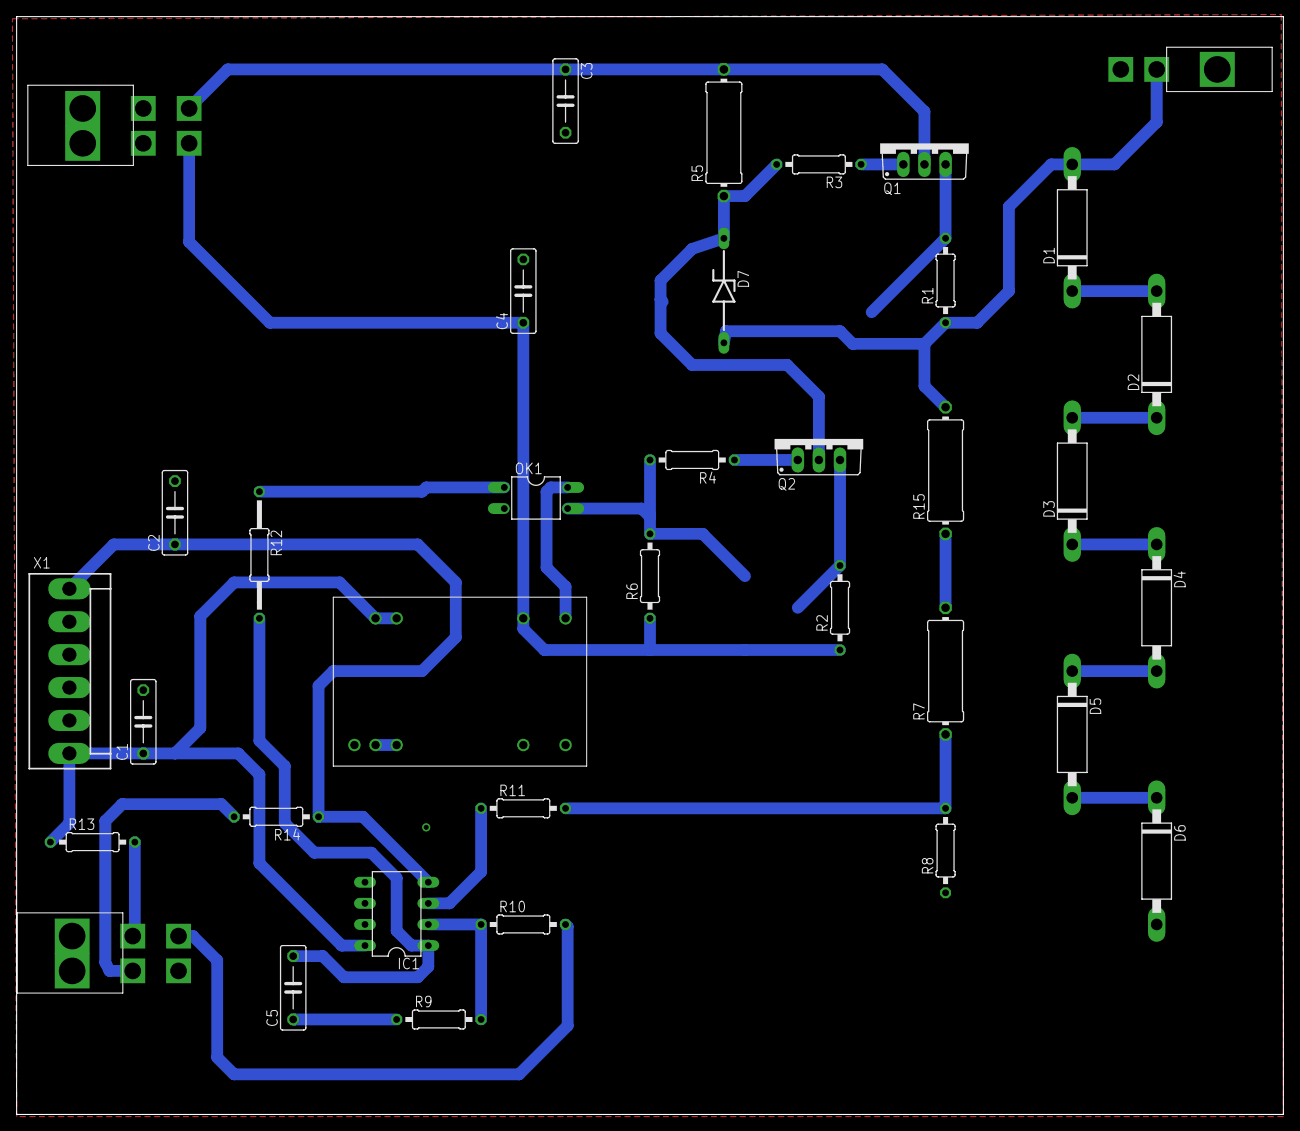
[picture p13: board test_ckt_2.brd from above]

Board: 2 copper layers, 152.4 x 132.1 mm, 36 parts (0 on the bottom side), 29 nets.
