joaquincasanova/ArdaraClone/(commit log)

2015-12-22 Clone of aradara regulator - 8 channel supply
    [ArdaraClone.kicad_pcb, ArdaraClone.sch, test_ckt.brd, test_ckt.sch]
2015-12-22 Fix pin assignment minifit Jr
    [test_ckt.brd, test_ckt.sch]
2016-01-06 More fixes...and a board with digital in
    [regulator_plus_switch.brd, regulator_plus_switch.sch]
2016-01-13 "Works" but not full scale yet
    [test_ckt.brd, test_ckt.sch]
2016-01-22 Solution to full scale?
    [test_ckt_2.brd, test_ckt_2.sch]
2016-02-24 pa 97 circuit
    [pa97.brd, pa97.sch, regulator_plus_switch.brd, regulator_plus_switch.sch, test_ckt.brd, test_ckt_2.brd, test_ckt_2.sch]
2016-02-24 add display out
    [regulator_plus_switch.brd, regulator_plus_switch.sch]
2016-02-29 pa97 test board
    [pa97.brd, pa97.sch]
2016-03-18 Test layouts pa97
    [pa97.brd, pa97.sch, regulator_plus_switch.brd, regulator_plus_switch.sch]
2016-03-25 overcurrent, worked out connectors
    [regulator_plus_switch.brd, regulator_plus_switch.sch]
2016-03-27 yay led switch worked out
    [regulator_plus_switch.brd, regulator_plus_switch.sch]
2016-03-29 big board
    [regulator_plus_switch_multi.brd, regulator_plus_switch_multi.sch]
2016-04-08 submit 8 chan
    [regulator_plus_switch_multi.brd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]
2016-04-26 fix multichannel bugs
    [regulator_plus_switch_multi.brd, regulator_plus_switch_multi_no_rdbk.brd, regulator_plus_switch_multi_no_rdbk.sch]
2016-05-18 all good
    [regulator_plus_switch_multi_no_rdbk.brd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]
